MisterDickson/Flip-Lever/Base/production/bom.csv

Designator | Footprint | Quantity | Value | LCSC Part #
C1 | CP_Radial_D5.0mm_P2.50mm | 1 | 22u
D1, D2 | LED_D5.0mm_Clear | 2 | LED
J1 | USB_C_Receptacle_GCT_USB4135-GF-A_6P_TopMnt_Horizontal | 1 | USB_C_Receptacle_PowerOnly_6P
J2 | PinSocket_1x04_P2.54mm_Vertical | 1 | Conn_01x04_Socket
R1, R2 | R_Axial_DIN0207_L6.3mm_D2.5mm_P10.16mm_Horizontal | 2 | 5k1
