MisterDickson/Flip-Lever/Drawings/mCAD/Lever_Drawing.pdf

# 10 mm distance to spheric drills

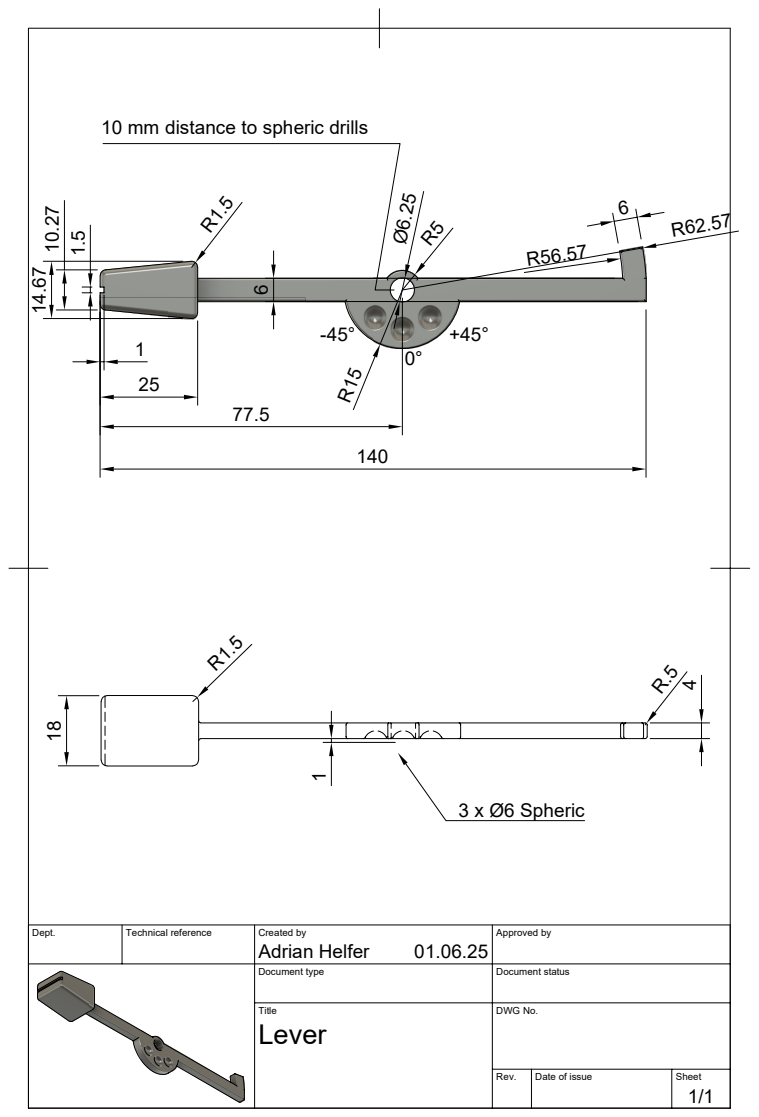
[picture p1: page 1]
Dept.; Technical reference; Created by; Approved by; Document type; Document status; Title; DWG No.; Rev.; Date of issue; Sheet; Lever; Adrian Helfer; 3 x Ø6 Spheric ¹
