MisterDickson/Flip-Lever/Drawings/eCAD/Base_Schematic.pdf

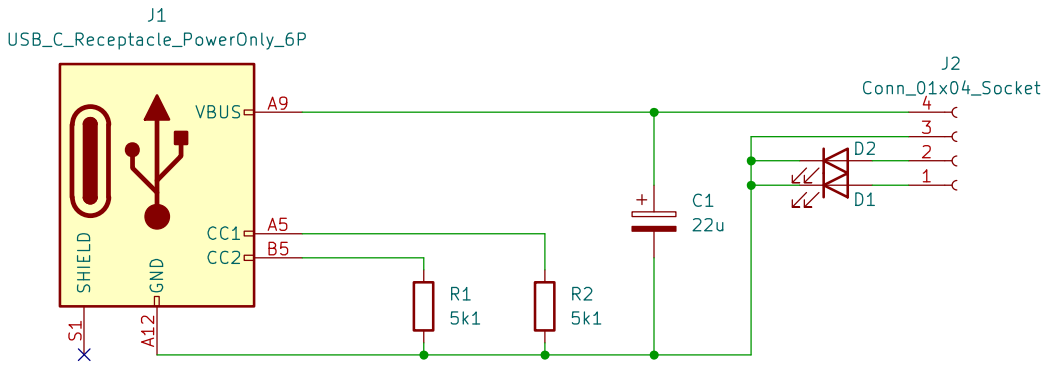
[picture p2: page 1]
