MisterDickson/Flip-Lever/Drawings/eCAD/Logic_Schematic.pdf

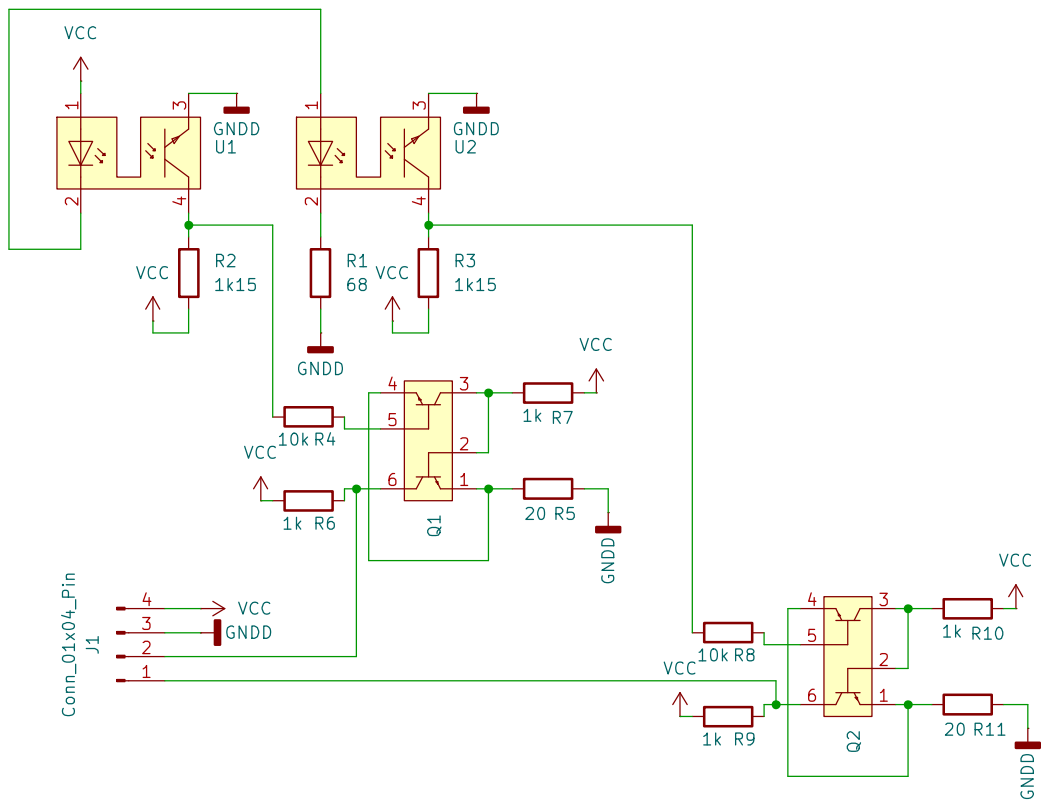
[picture p3: page 1]
