MisterDickson/Flip-Lever/Drawings/mCAD/Base_Drawing.pdf

6 9.77 19 2.9 2.56 6.29 7.44 8.59

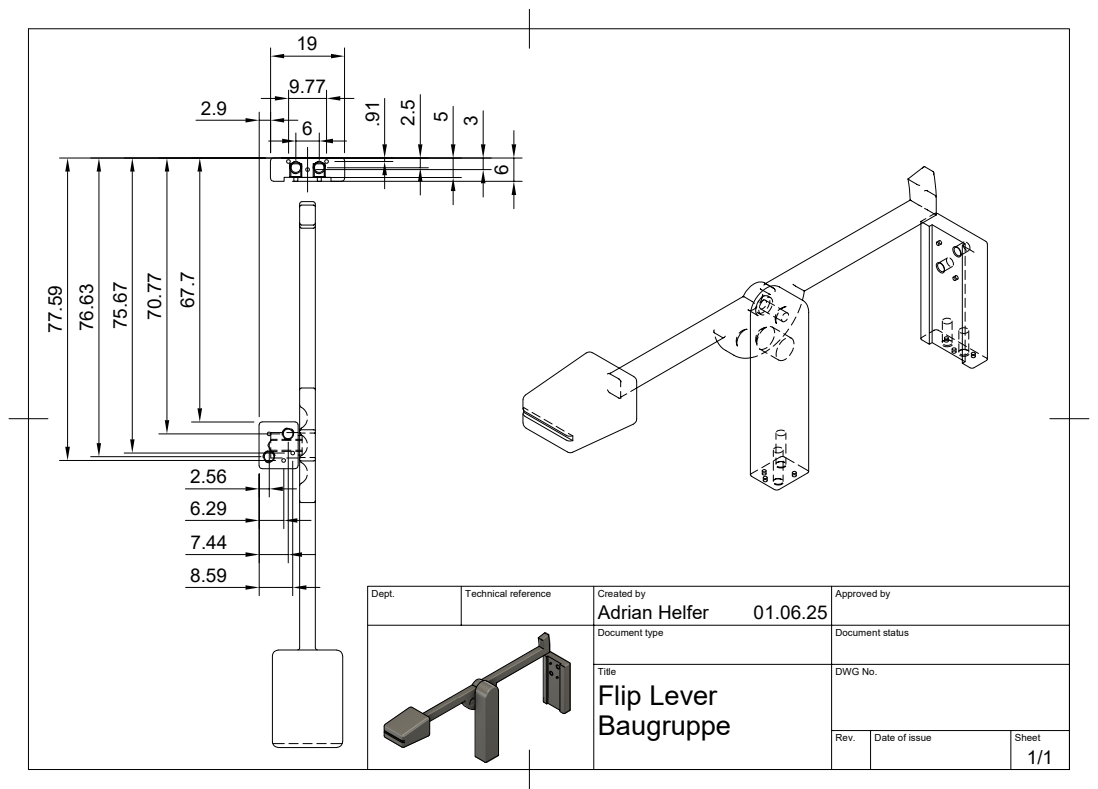
[picture p4: page 1]
Dept.; Technical reference; Created by; Approved by Document type; Document status Title; DWG No. Rev.; Date of issue; Sheet 01.06.25; 1/1 Baugruppe Flip Lever Adrian Helfer
