MisterDickson/Flip-Lever/Drawings/mCAD/Logic_Rest_Drawing.pdf

6

12

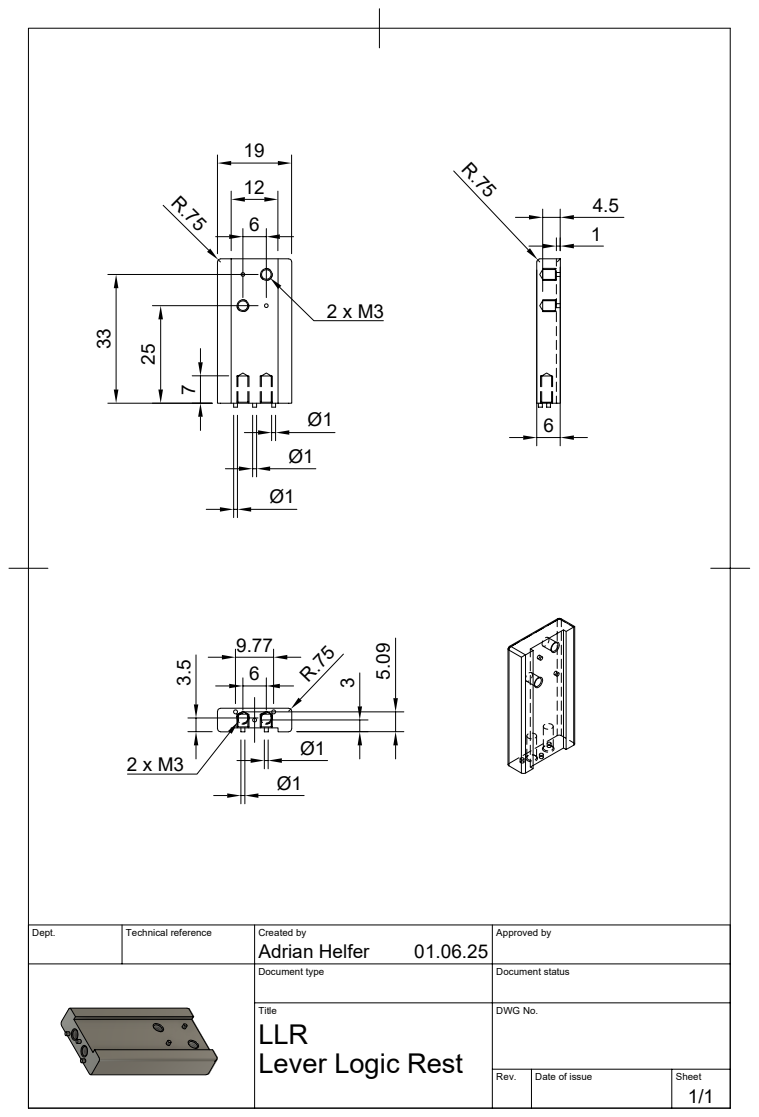
[picture p5: page 1]
Dept.; Technical reference; Created by; Approved by; Document type; Document status; Title; DWG No.; Rev.; Date of issue; Sheet; Adrian Helfer

LLR
Lever Logic Rest
