MisterDickson/Flip-Lever/Drawings/mCAD/Stand_Drawing.pdf

M3
1

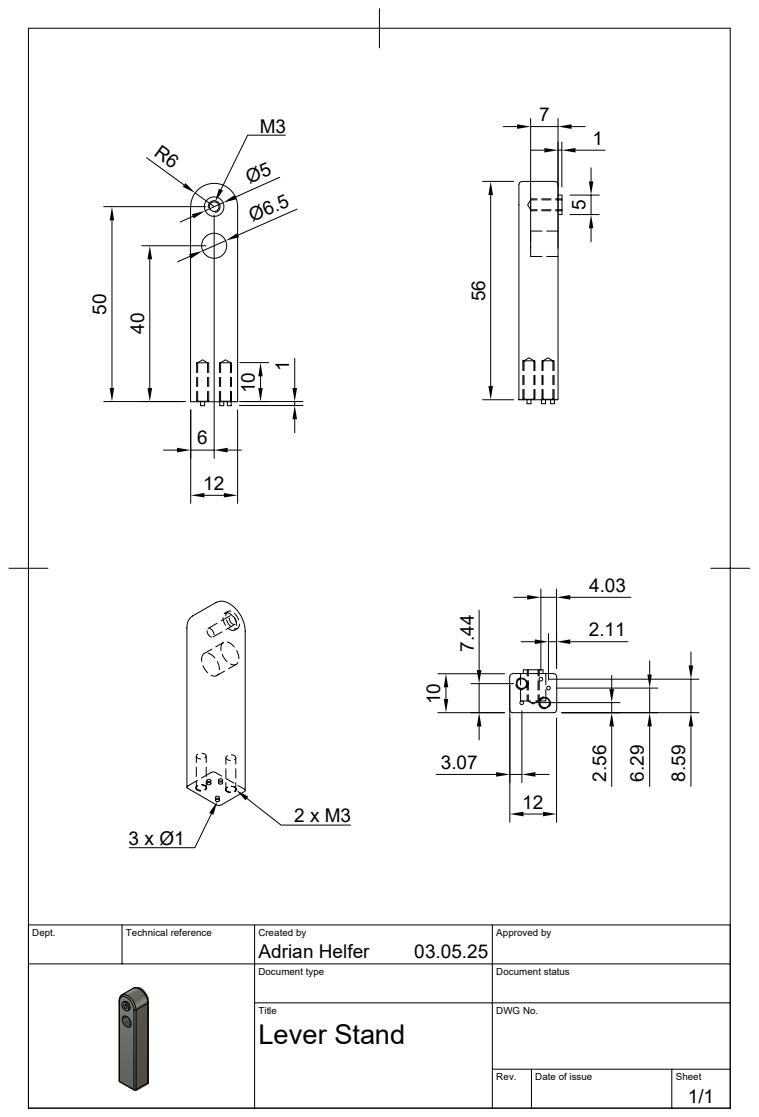
[picture p6: page 1]
Dept.; Technical reference; Created by; Approved by; Document type; Document status; Title; DWG No.; Rev.; Date of issue; Sheet; Lever Stand; Adrian Helfer; 12 ⁴⁰⁵⁰
