MisterDickson/Flip-Lever/Drawings/eCAD/Base_PCB.pdf

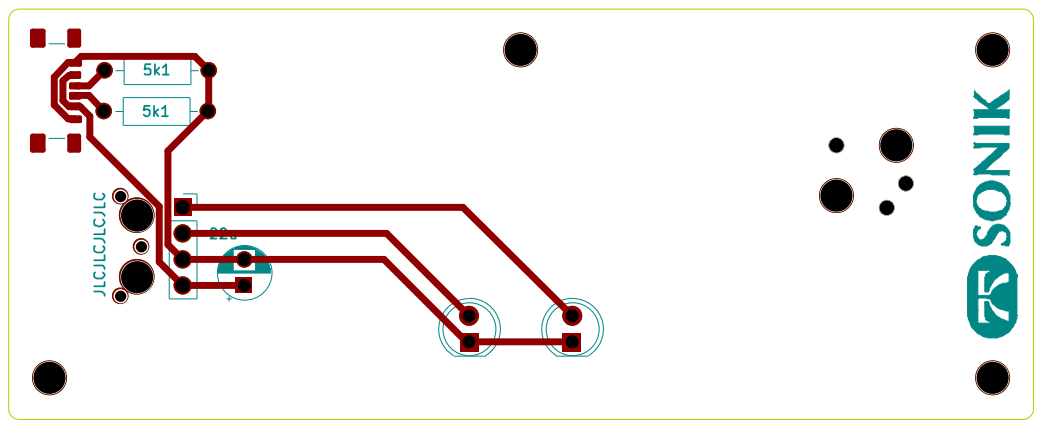
[picture p7: page 1]
