MisterDickson/Flip-Lever/Drawings/eCAD/Logic_PCB.pdf

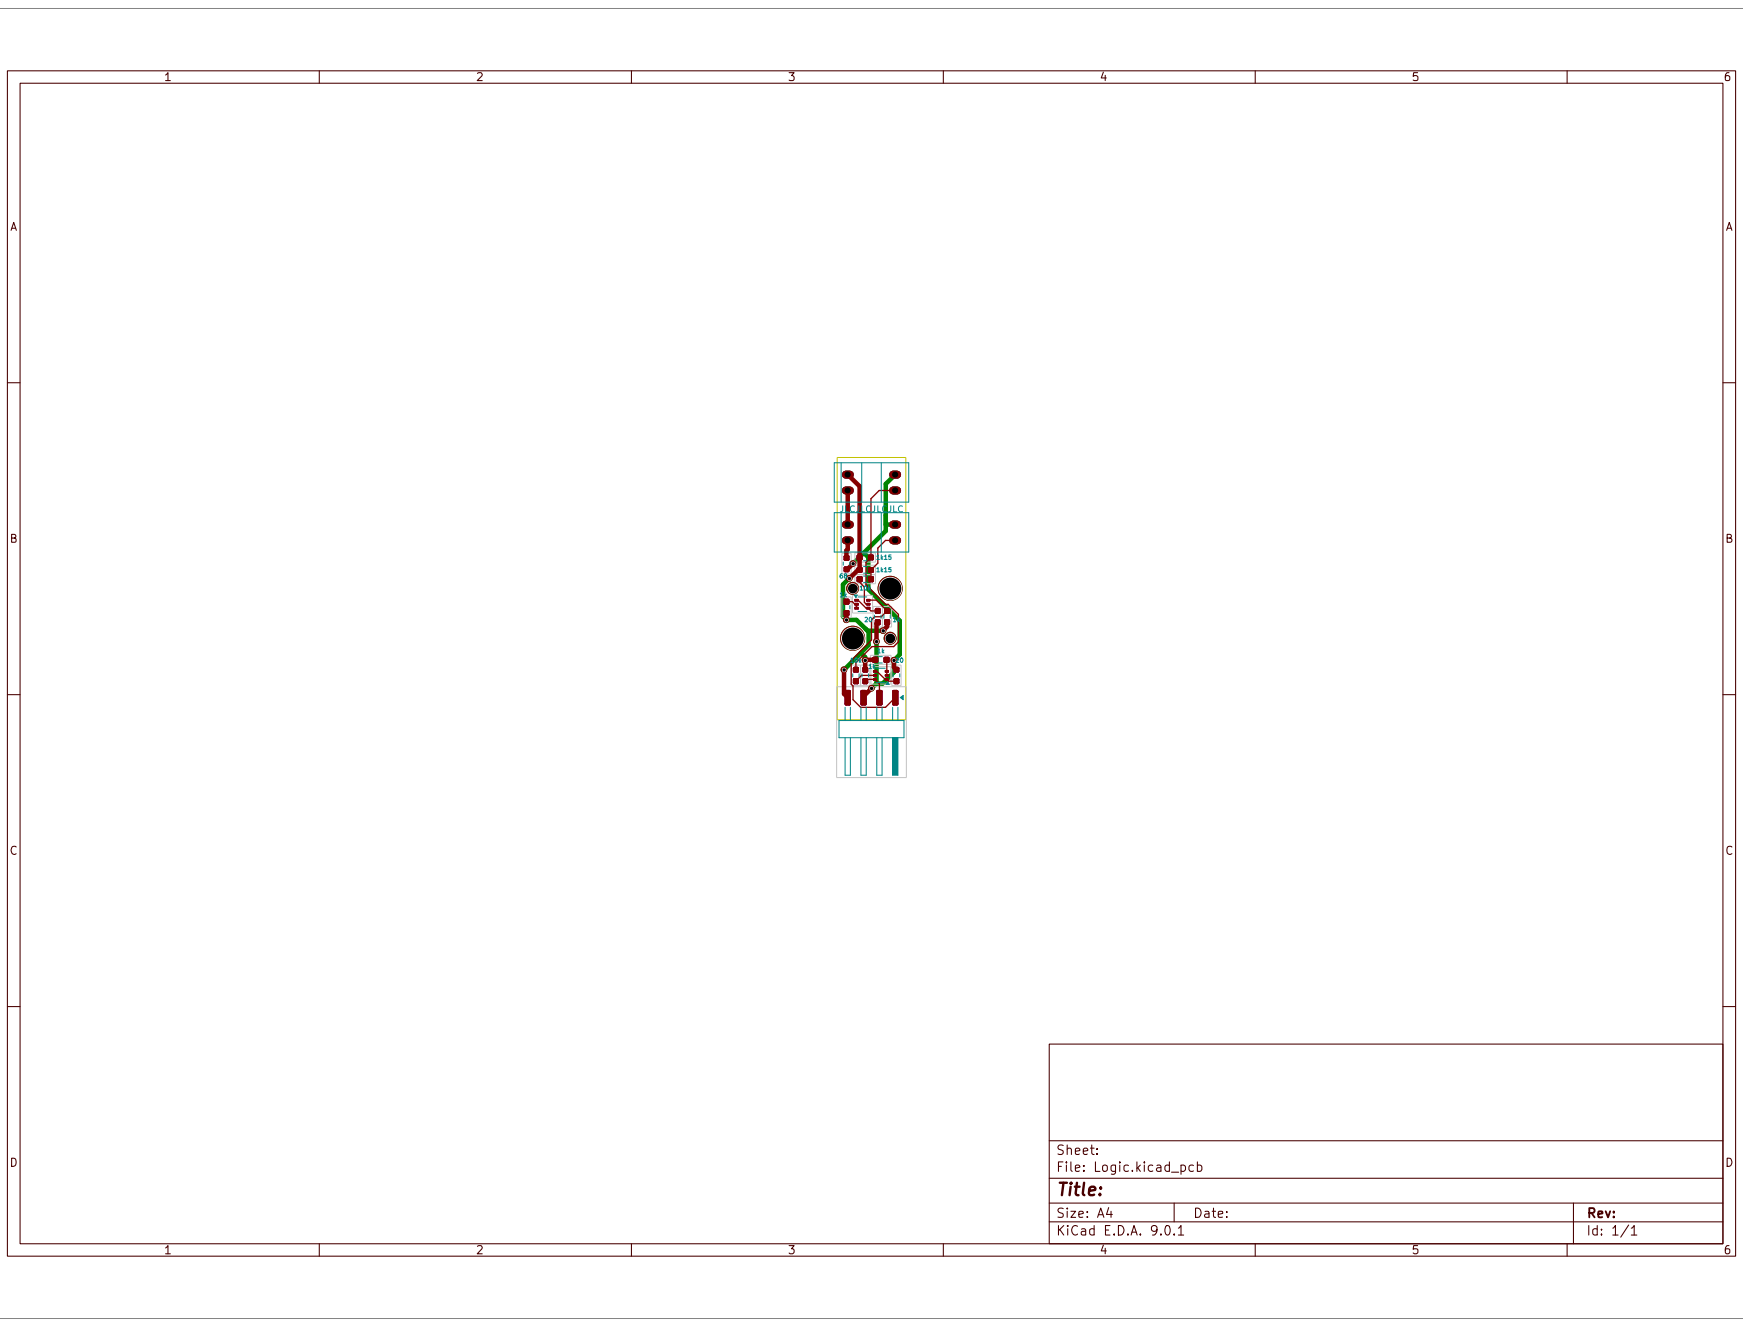
[picture p8: page 1]
