MisterDickson/Flip-Lever/Base/Base.kicad_pcb

## KiCad design Base/Base.kicad_pcb (2025-05-22)

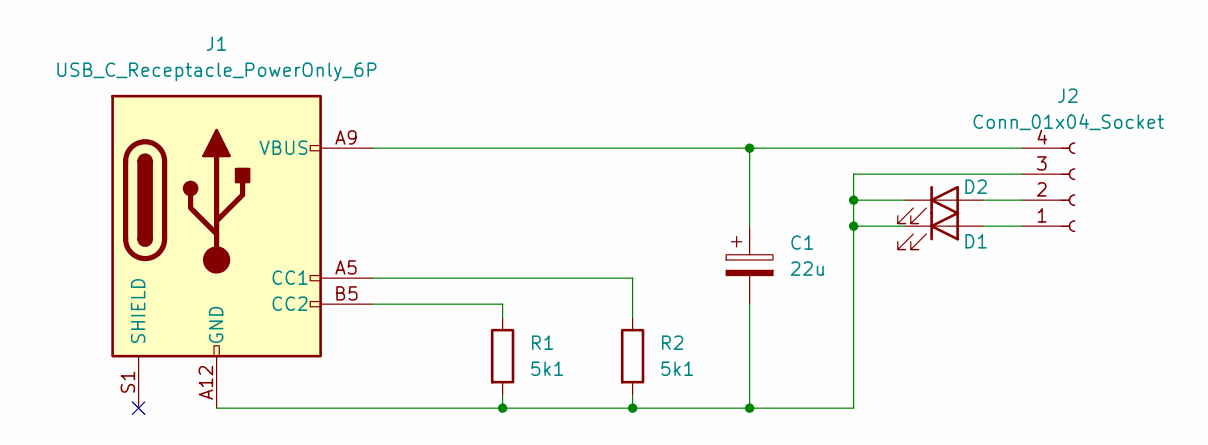
[picture p9: schematic Base.kicad_sch]

Parts:
C1: 22u; CP_Radial_D5.0mm_P2.50mm
D1, D2: LED; LED_D5.0mm_Clear
J1: USB_C_Receptacle_PowerOnly_6P; USB_C_Receptacle_GCT_USB4135-GF-A_6P_TopMnt_Horizontal
J2: Conn_01x04_Socket; PinSocket_1x04_P2.54mm_Vertical
R1, R2: 5k1; R_Axial_DIN0207_L6.3mm_D2.5mm_P10.16mm_Horizontal

Connections:
unnamed: D1.2 (A), J2.1
unnamed: C1.2, D1.1 (K), D2.1 (K), J1.A12 (GND), J1.B12 (GND), J2.3, R1.2, R2.2
unnamed: D2.2 (A), J2.2
unnamed: J1.A5 (CC1), R2.1
unnamed: J1.B5 (CC2), R1.1
unnamed: C1.1, J1.A9 (VBUS), J1.B9 (VBUS), J2.4

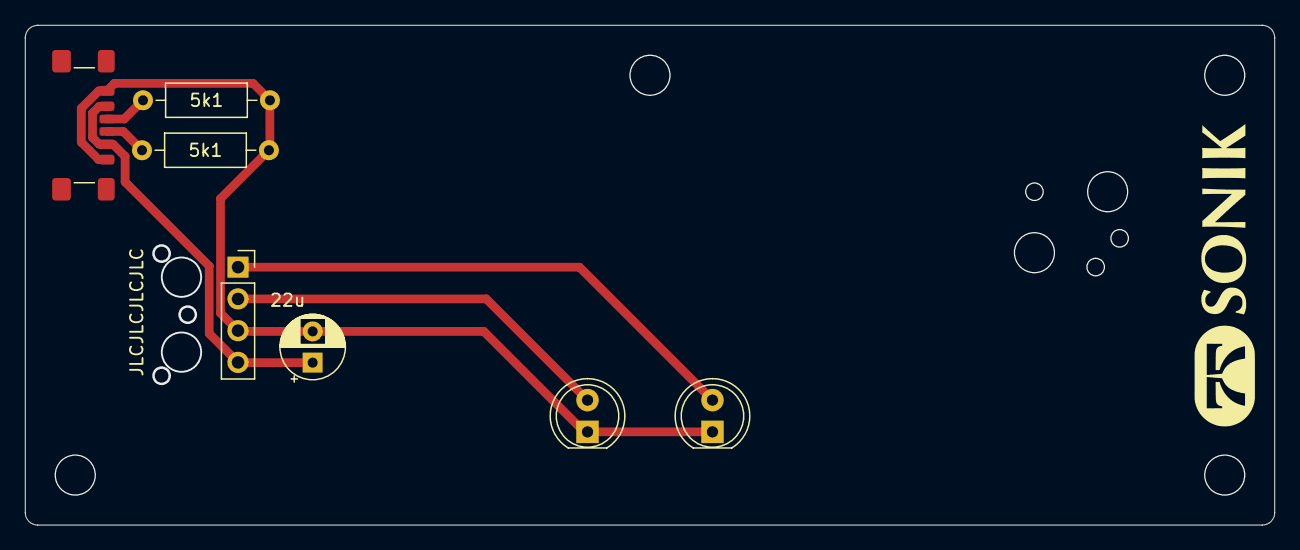
[picture p10: board Base.kicad_pcb from above]

Board: 2 copper layers, 100.0 x 40.0 mm, 7 parts (0 on the bottom side), 6 nets.
