MisterDickson/Flip-Lever/Logic/Logic.kicad_pcb

## KiCad design Logic/Logic.kicad_pcb (2025-05-05)

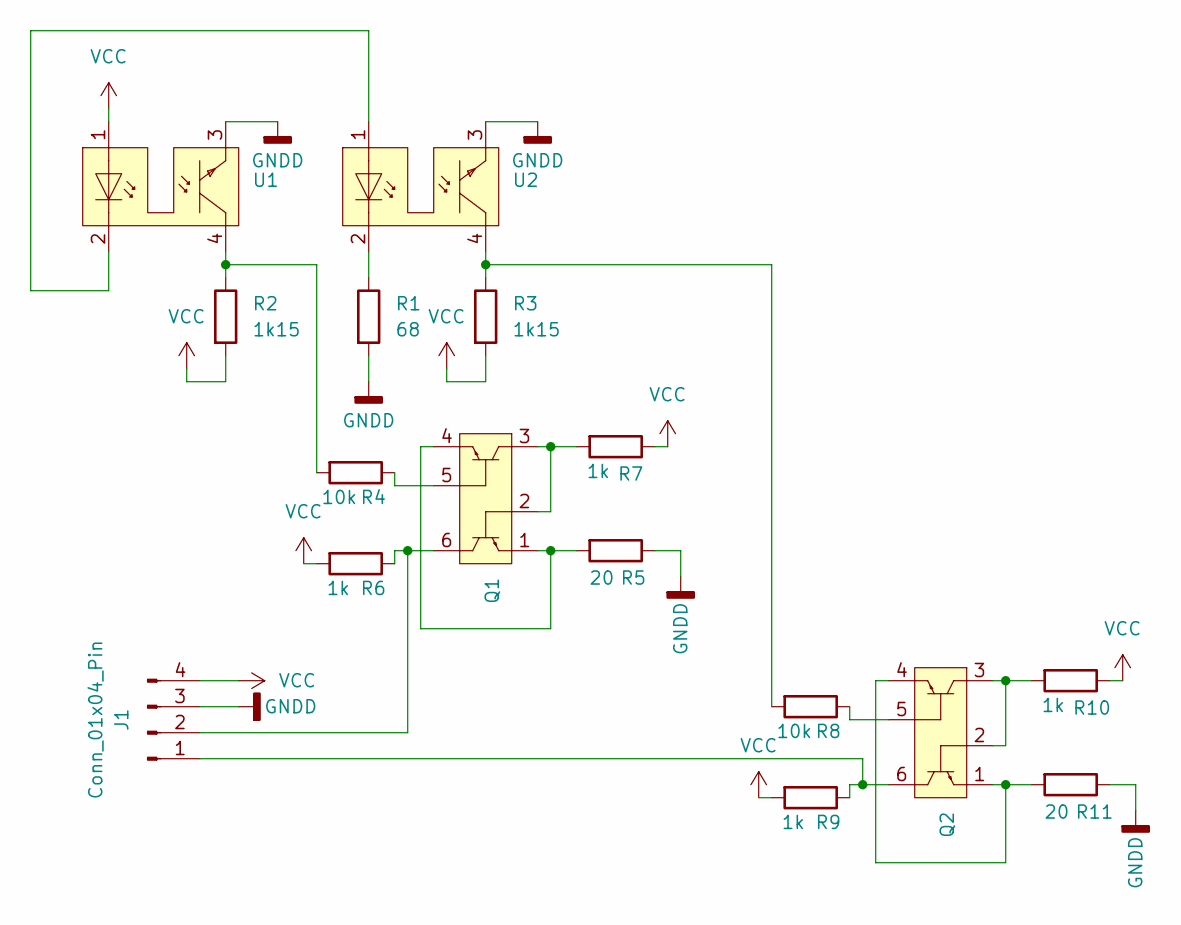
[picture p11: schematic Logic.kicad_sch]

Parts:
J1: Conn_01x04_Pin; Harwin_M20-89004xx_1x04_P2.54mm_Horizontal
Q1, Q2: SOT-363_SC-70-6
R1: 68; R_0603_1608Metric_Pad0.98x0.95mm_HandSolder
R2, R3: 1k15; R_0603_1608Metric_Pad0.98x0.95mm_HandSolder
R4, R8: 10k; R_0603_1608Metric_Pad0.98x0.95mm_HandSolder
R5, R11: 20; R_0603_1608Metric_Pad0.98x0.95mm_HandSolder
R6, R7, R9, R10: 1k; R_0603_1608Metric_Pad0.98x0.95mm_HandSolder
U1, U2: OPTO-THT-TCST1103

Connections:
GNDD: J1.3, R1.2, R5.1, R11.1, U1.3, U2.3
unnamed: J1.1, Q2.6, R9.1
unnamed: J1.2, Q1.6, R6.1
unnamed: Q1.1, Q1.4, R5.2
unnamed: Q1.2, Q1.3, R7.2
unnamed: Q1.5, R4.1
unnamed: Q2.1, Q2.4, R11.2
unnamed: Q2.2, Q2.3, R10.2
unnamed: Q2.5, R8.1
unnamed: R1.1, U2.2
unnamed: R2.1, R4.2, U1.4
unnamed: R3.1, R8.2, U2.4
unnamed: U1.2, U2.1
VCC: J1.4, R2.2, R3.2, R6.2, R7.1, R9.2, R10.1, U1.1

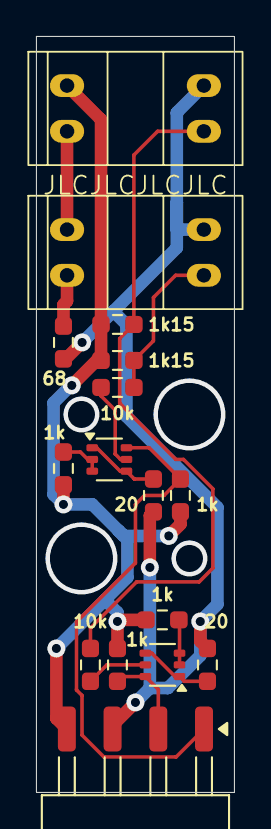
[picture p12: board Logic.kicad_pcb from above]

Board: 2 copper layers, 11.0 x 42.0 mm, 16 parts (0 on the bottom side), 14 nets.
