MisterDickson/Flip-Lever/(commit log)

2025-05-04 Add Schmitt-Trigger and Datasheets
    [Logic.kicad_sch]
2025-05-05 user save
    [Logic.kicad_pcb, Logic.kicad_sch]
2025-05-05 user saved
    [Logic.kicad_pcb]
2025-05-05 init base
    [Base.kicad_pcb, Base.kicad_sch]
2025-05-05 schematic update
    [Base.kicad_sch]
2025-05-05 quick save
    [Base.kicad_pcb]
2025-05-05 add components
    [Base.kicad_pcb]
2025-05-05 update pcb
    [Base.kicad_pcb]
2025-05-05 RC2
    add fab s/n placeholder
    [Logic.kicad_pcb]
2025-05-05 RC2, un-ground shield
    [Base.kicad_pcb, Base.kicad_sch]
2025-05-05 add production files
    [bom.csv, designators.csv, positions.csv]
2025-05-06 add BOM
    [BOM.csv]
2025-05-22 update drill holes
    notified by jlc about the fab capabilities. 3.1 to 3 mm, 1.3 to 1.1 mm. tested. works. even better
